davidholmes1066/HR_Monitor/TEP000/TEP000.kicad_pcb

## KiCad design TEP000/TEP000.kicad_pcb (2024-09-05)

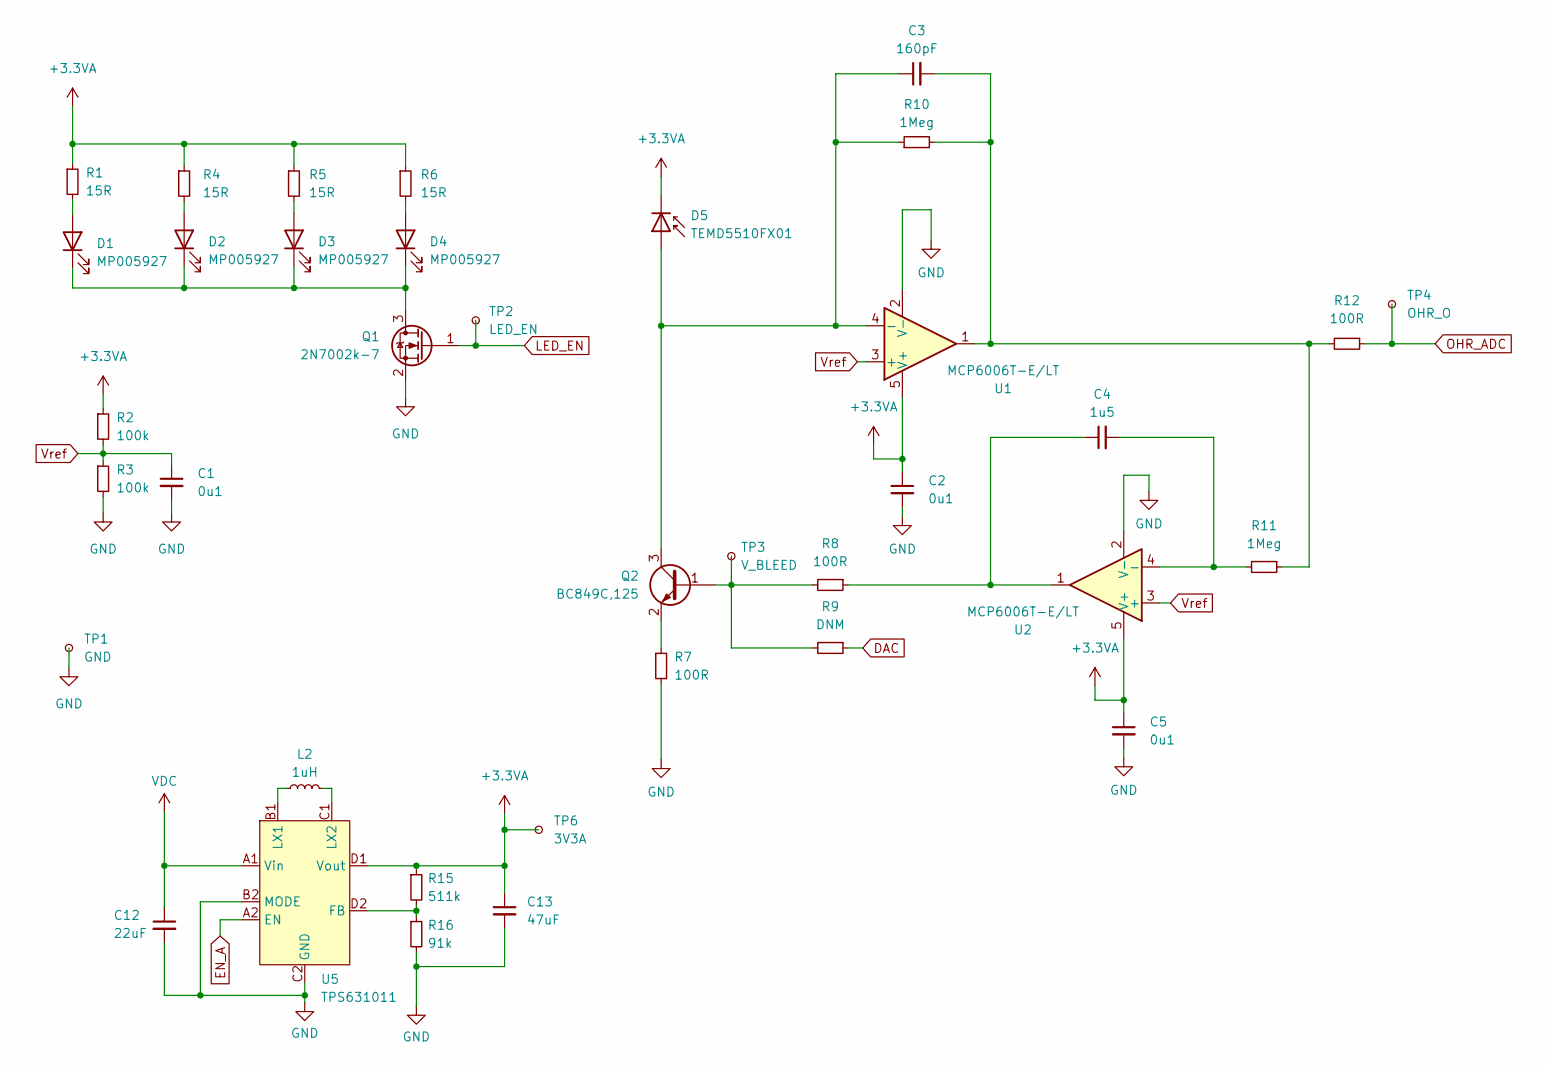
[picture p1: schematic Analog.kicad_sch]

Parts:
C1, C2, C5: 0u1; C_0402_1005Metric; Farnell 2627420
C3: 160pF; C_0402_1005Metric; Farnell 1758977
C4: 1u5; C_0603_1608Metric; Farnell 4066708
C12: 22uF; C_0805_2012Metric; Farnell 3013461
C13: 47uF; C_0805_2012Metric; Farnell 3582869
D1, D2, D3, D4: MP005927; D_0603_1608Metric
D5: TEMD5510FX01
L2: 1uH; L_0805_2012Metric_Pad1.05x1.20mm_HandSolder; Farnell 2616845
Q1: 2N7002k-7; SOT-23-3; Farnell 1713825
Q2: BC849C,125; SOT-23; Farnell 1081237
R1, R4, R5, R6: 15R; R_01005_0402Metric; Farnell 3994380
R2, R3: 100k; R_0402_1005Metric; Farnell 2502803
R7, R8, R12: 100R; R_0402_1005Metric; Farnell 2447095
R9: DNM; R_0402_1005Metric
R10, R11: 1Meg; R_0402_1005Metric; Farnell 2502805
R15: 511k; R_0402_1005Metric; Farnell 3950930
R16: 91k; R_0402_1005Metric; Farnell 2073314
TP1: GND; TestPoint_Pad_D1.0mm
TP2: LED_EN; TestPoint_Pad_D1.0mm
TP3: V_BLEED; TestPoint_Pad_D1.0mm
TP4: OHR_O; TestPoint_Pad_D1.0mm
TP6: 3V3A; TestPoint_Pad_D1.0mm
U1, U2: MCP6006T-E/LT; SOT-353_SC-70-5; Farnell 3807531
U5: TPS631011; Texas_DSBGA-8_0.705x1.468mm_Layout2x4_P0.4mm

Connections:
+3.3VA: C2.1, C5.1, C13.1, D5.1 (K), R1.1, R2.1, R4.1, R5.1, R6.1, R15.1, TP6.1, U1.5 (V+), U2.5 (V+), U5.D1 (Vout)
DAC: R9.1; also elsewhere on the board
EN_A: U5.A2 (EN); also elsewhere on the board
GND: C1.2, C2.2, C5.2, C12.2, C13.2, Q1.2 (S), R3.2, R7.2, R16.2, TP1.1, U1.2 (V-), U2.2 (V-), U5.B2 (MODE), U5.C2 (GND); also elsewhere on the board
LED_EN: Q1.1 (G), TP2.1; also elsewhere on the board
unnamed: C3.2, R10.2, R11.1, R12.2, U1.1
unnamed: C4.1, R8.1, U2.1
unnamed: D1.2 (A), R1.2
unnamed: D1.1 (K), D2.1 (K), D3.1 (K), D4.1 (K), Q1.3 (D)
unnamed: D2.2 (A), R4.2
unnamed: D3.2 (A), R5.2
unnamed: D4.2 (A), R6.2
unnamed: C3.1, D5.2 (A), Q2.3 (C), R10.1, U1.4 (-)
unnamed: Q2.1 (B), R8.2, R9.2, TP3.1
unnamed: Q2.2 (E), R7.1
unnamed: C4.2, R11.2, U2.4 (-)
unnamed: R15.2, R16.1, U5.D2 (FB)
unnamed: L2.1, U5.B1 (LX1)
unnamed: L2.2, U5.C1 (LX2)
OHR_ADC: R12.1, TP4.1; also elsewhere on the board
VDC: C12.1, U5.A1 (Vin); also elsewhere on the board
Vref: C1.1, R2.2, R3.1, U1.3 (+), U2.3 (+)

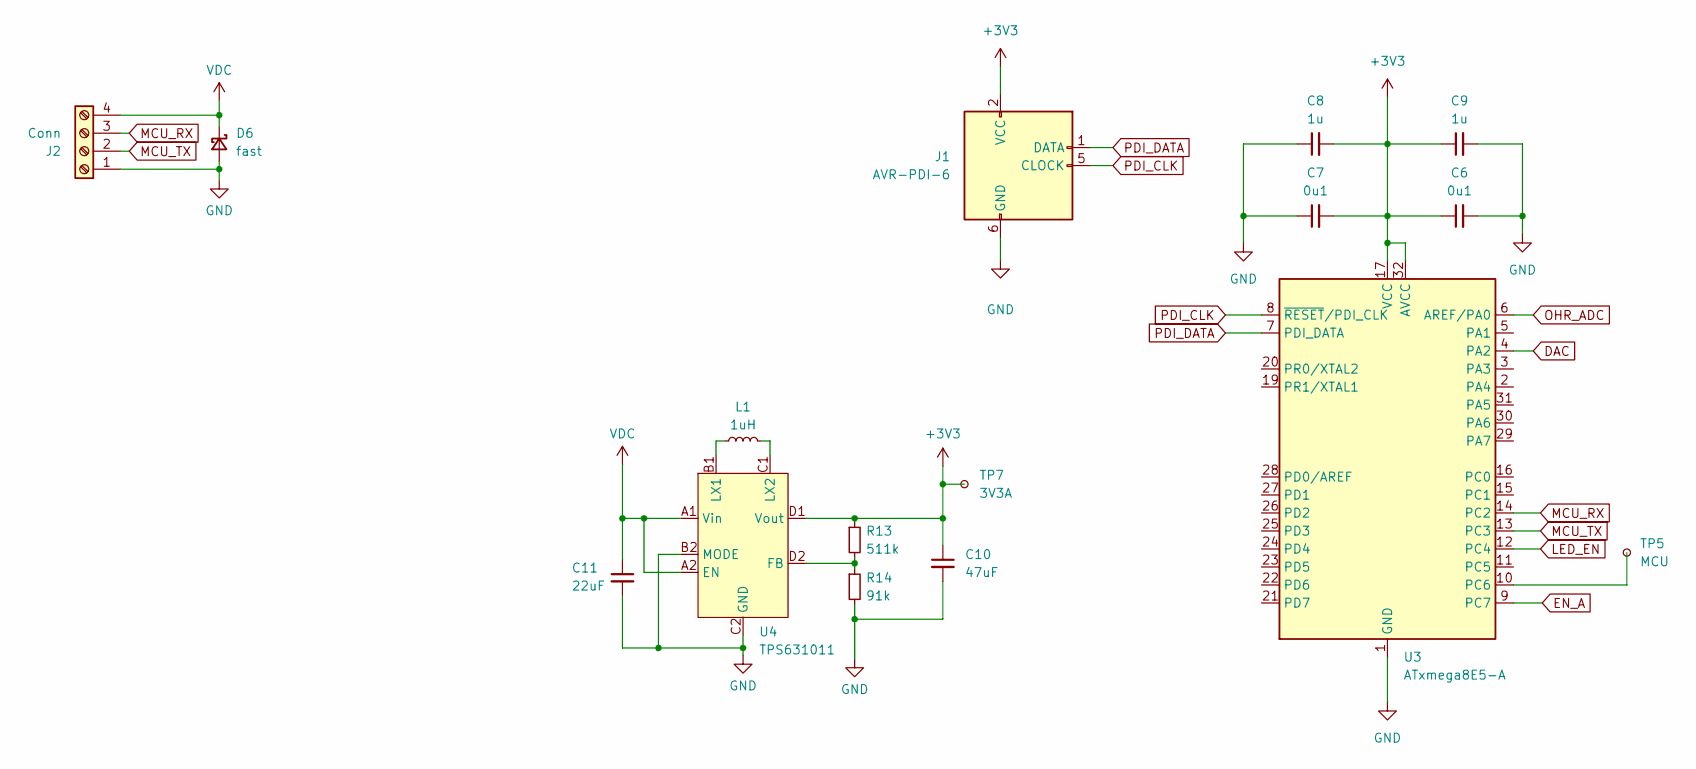
[picture p2: schematic MCU.kicad_sch]

Parts:
C6, C7: 0u1; C_0402_1005Metric; Farnell 2627420
C8, C9: 1u; C_0402_1005Metric; Farnell 3013330
C10: 47uF; C_0805_2012Metric; Farnell 3582869
C11: 22uF; C_0805_2012Metric; Farnell 3013461
D6: fast; D_SOD-128; Farnell 1829204
J1: AVR-PDI-6; PDI_AVR_TagConnect
J2: Conn; 3.81mm4PosTerm_2007987; Farnell 2007987
L1: 1uH; L_0805_2012Metric_Pad1.05x1.20mm_HandSolder; Farnell 2616845
R13: 511k; R_0402_1005Metric; Farnell 3950930
R14: 91k; R_0402_1005Metric; Farnell 2073314
TP5: MCU; TestPoint_Pad_D1.0mm
TP7: 3V3A; TestPoint_Pad_D1.0mm
U3: ATxmega8E5-A; TQFP-32_7x7mm_P0.8mm
U4: TPS631011; Texas_DSBGA-8_0.705x1.468mm_Layout2x4_P0.4mm

Connections:
3V3A_EN: U3.11 (PC5)
+3V3: C6.1, C7.2, C8.2, C9.1, C10.1, J1.2 (VCC), R13.1, TP7.1, U3.17 (VCC), U3.32 (AVCC), U4.D1 (Vout)
DAC: U3.4 (PA2); also elsewhere on the board
EN_A: U3.9 (PC7); also elsewhere on the board
GND: C6.2, C7.1, C8.1, C9.2, C10.2, C11.2, D6.2 (A), J1.6 (GND), J2.1, R14.2, U3.1 (GND), U3.18 (GND), U4.B2 (MODE), U4.C2 (GND); also elsewhere on the board
LED_EN: U3.12 (PC4); also elsewhere on the board
MCU_RX: J2.3, U3.14 (PC2)
MCU_TX: J2.2, U3.13 (PC3)
unnamed: TP5.1, U3.10 (PC6)
unnamed: L1.1, U4.B1 (LX1)
unnamed: R13.2, R14.1, U4.D2 (FB)
unnamed: L1.2, U4.C1 (LX2)
OHR_ADC: U3.6 (AREF/PA0); also elsewhere on the board
PDI_CLK: J1.5 (CLOCK), U3.8 (~RESET/PDI_CLK)
PDI_DATA: J1.1 (DATA), U3.7 (PDI_DATA)
VDC: C11.1, D6.1 (K), J2.4, U4.A1 (Vin), U4.A2 (EN); also elsewhere on the board

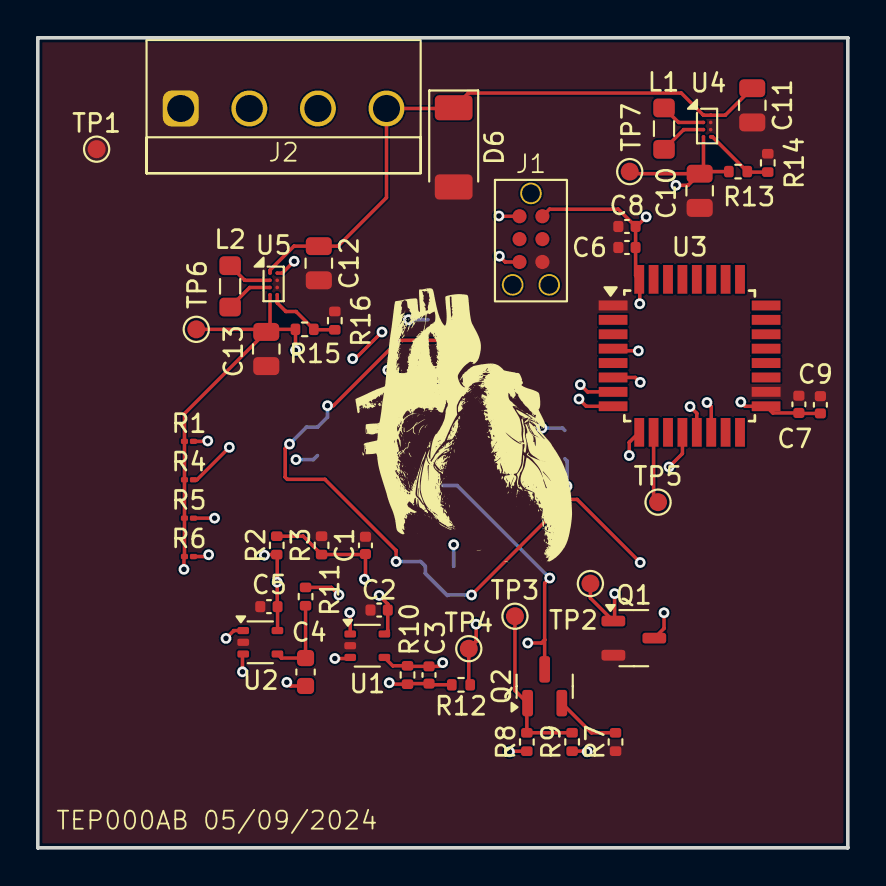
[picture p3: board TEP000.kicad_pcb from above]

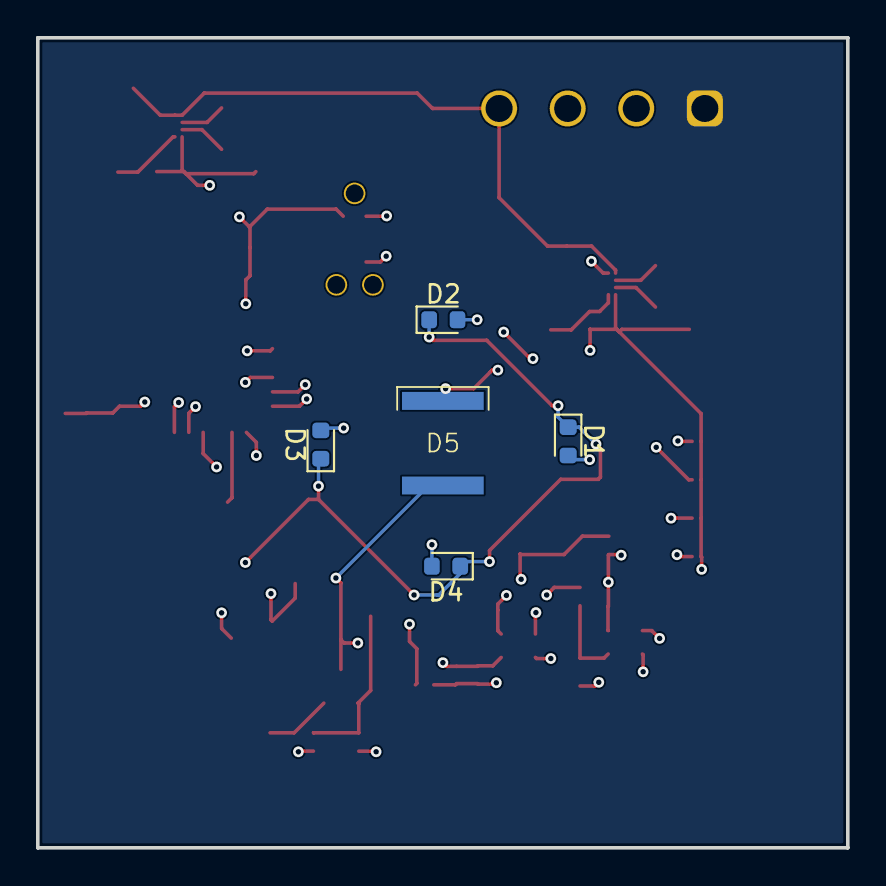
[picture p4: board TEP000.kicad_pcb from below]

Board: 4 copper layers, 45.0 x 45.0 mm, 53 parts (5 on the bottom side), 31 nets.
