davidholmes1066/HR_Monitor/(commit log)

2024-08-03 added LED and Photodiodes
    [TEP000.kicad_pcb, TEP000.kicad_sch]
2024-08-06 added transimpedance amplifier
    [TEP000.kicad_sch]
2024-08-09 First rev of TEP000 Prototype
    [TEP000-B_Cu.gbr, TEP000-B_Mask.gbr, TEP000-B_Paste.gbr, TEP000-B_Silkscreen.gbr, TEP000-Edge_Cuts.gbr, TEP000-F_Cu.gbr, TEP000-F_Mask.gbr, TEP000-F_Paste.gbr]
2024-08-28 TEP000AA
    Device works but now way of filtering out the DC offset current saturating the amplifier. Should be made cheaper and possibly with a single supply. Will add an MCU so that a first revision of the firmware can be made.
2024-08-28 Started work on rev AB
    [TEP000.kicad_sch]
2024-09-05 TEP000AB
    Added buck-boost converters, MCU and integrator bleed circuit.
    [Analog.kicad_sch, MCU.kicad_sch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]
